l8-e/modules-Clock2Arduino/README.md

# Clock2Arduino
Documentation and Code of an Eurorack Module, which realizes a Clock Input into an [Arduino Nano](https://store.arduino.cc/products/arduino-nano)

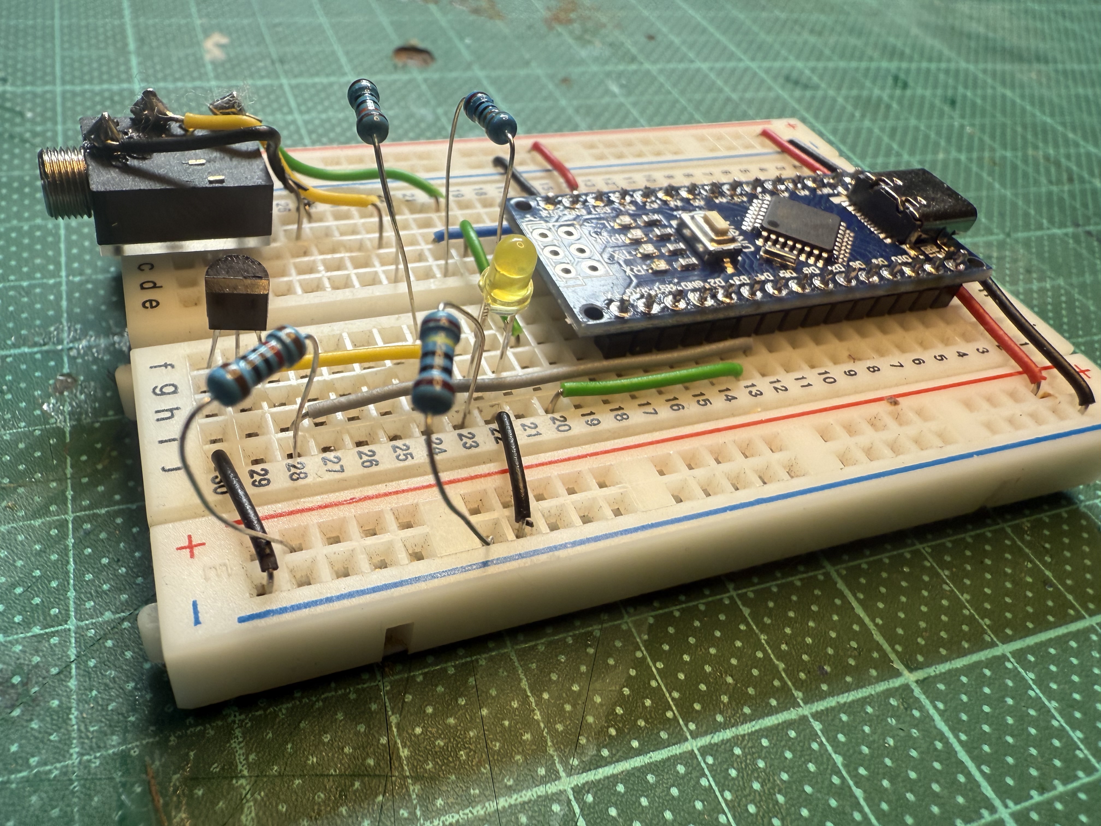
[picture p1: images/Perspective.jpg]
the current working state of the breadboard implementation


# About
I am working to build an Arduino Nano based Sequencer as Eurorack Module. 

For this I wanted to have an optional Clock Input, i.e. an jack, where one can plug  in a click signal, but does not have to. If nothing is plugged in, the Arduino shall use an internal clock instead. 
This repository here contains the schematics to build this and the code for the arduino to manage an internal clock, read an external clock and work with the corresponding signal. 

## Input Guard
An Arduino nano has some digital inputs, which expect to be either ~0V or at ~5V. Eurorack Modules create signals, which are often at ~5V, but they can be higher (or lower) in voltage, so 
it is quite risky to directly wire the input signal to the Arduino. Instead, some guarding or shielding is required to protect the arduino from being fried. 

Googling how to do this led me to this [reddit thread](https://www.reddit.com/r/synthdiy/comments/hpzyuz/what_do_i_need_to_make_an_arduino_input_pin/). From there I found the documentation of the [big honking button](https://blog.thea.codes/designing-big-honking-button/), some Eurorack Module, which has a shielded gate input. And from there I stumbled into the schematics of the [grids-module](https://pichenettes.github.io/mutable-instruments-documentation/modules/grids/downloads/grids_v02.pdf) of mutable instruments / Emilie Gillet. 

All three used an NPN-Transistor where the input-signal is connected to the base. The emitter is connected to the ground and the transistor's collector is directly connected to the arduino's input signal and via a resistor connected the 5v output of the arduino. This means, the arduino input is HIGH, when no input signal is present and as soon as the input signal receives a signal, the transistor opens up and pulls the input signal down to LOW. 
As transistor I followed the big honking button schematics and decided to go with an `2N3904`. The resistor sizes I copied from the grids design. Finally, I choose to use the `d02` port of the Arduino as input. 
This looks as follows: 

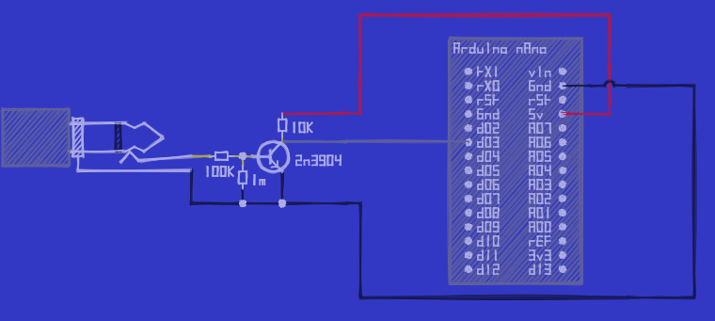
[picture p2: images/BasicGuard.png]
basic schematic of the input guard


## Make external clock Signal optional
Next, I wanted the make the clock signal optional. So I programmed an internal clock signal, which the Arduino puts out to its `d03` port. So I used a 3.5mm jack with a switch instead of an unswitched one and directly connected the `d03` port to the switch. This can be seen as the light green connection in the next image:

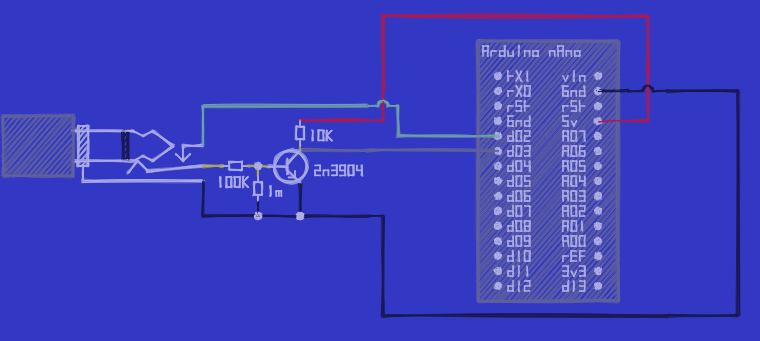
[picture p3: images/GuardWithInternalClockSignal.png]
basic schematic of the input guard


Here, it does not change anything, because a plug is inserted, which disconnects the yellow input signal from the green internal clock signal. But if no plug is present as seen in the third image, both get connected and the Arduino feeds its internal clock signal via the guard to the `d02` port and reads it there again:

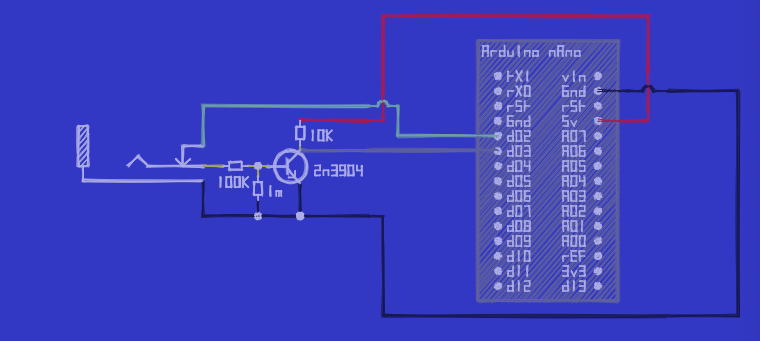
[picture p4: images/GuardWithInternalClockSignalUnplugged.png]
basic schematic of the input guard


## Add an clock LED
Last but not least I did add a LED to the port `d13` of the Arduino, such that the Arduino can show its read clock state. This mainly is for debugging and being able to see, what is going on there. This is the final schematic:

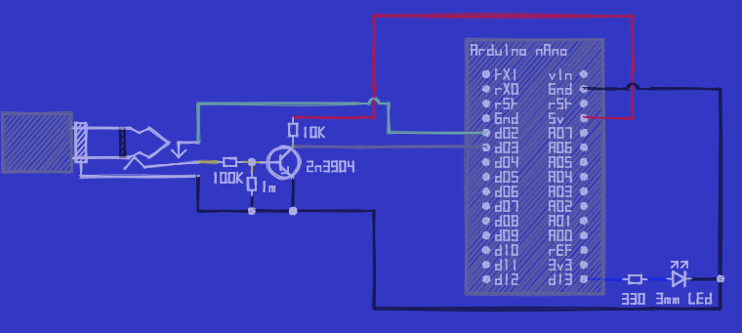
[picture p5: images/GuardWithClockLed.png]
basic schematic of the input guard


## Programming the Arduino Nano

The code for the arduino is pretty straight forward. It does not use external libraries and thus has no external dependencies. 
It creates an internal clock signal with a configurable speed and signal uptime. 
It reads an external clock signal and syncs the clock led either to the internal clock signal (for debugging) or to the external one (which might fall back to the internal one, if no plug is present in the input jack).
The code can be found in [Clock2Arduino.ino](./Clock2Arduino/Clock2Arduino.ino).

## Breadboarding

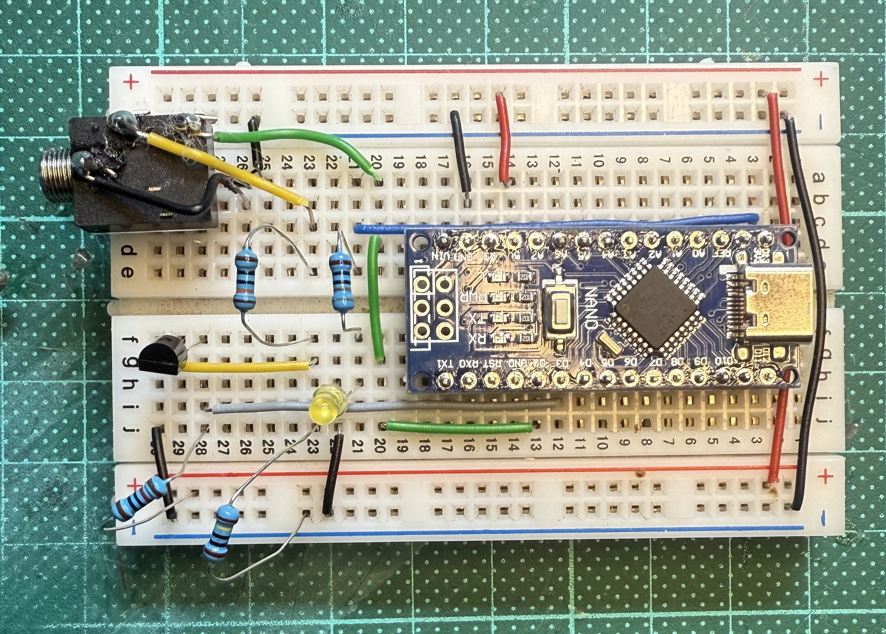
[picture p6: images/BreadBoard.jpg]
top view of the breakboard


## Using Arduino's input pullup resistor
[asciisynth](https://www.instagram.com/asciisynth/) (https://blinkenl.info) told me on instagram about the pullup resistor of the arduino. Basically, you 
can easily connect the input pin of the Arduino *in* the Arduino to +5V with a 10k resistor inbetween. In my schematic I did this by hand, 
but by changing the line `pinMode(CLOCK_IN,  INPUT);` to `pinMode(CLOCK_IN,  INPUT_PULLUP);` one can remove the resistor from the schematic and simplify it. 
This looks as follows: 

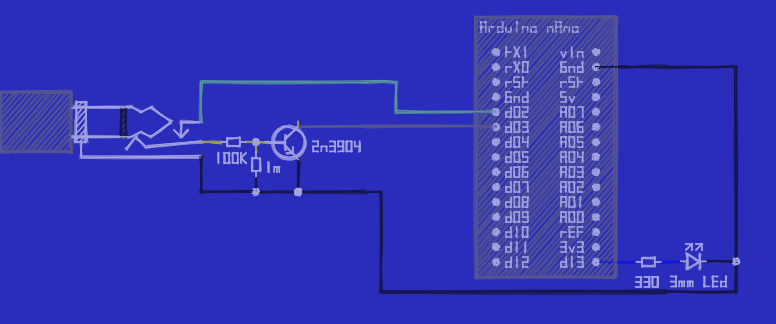
[picture p7: images/UsingInputPullup.png]
improved schematic of the input guard


The code at [Clock2Arduino.ino](./Clock2Arduino/Clock2Arduino.ino) contains now an additionel `#define` which defines, if the internal or an external pullup resistor 
shall be used. 

## Using hardware interrupts to simplify the loop
Again, [asciisynth](https://www.instagram.com/asciisynth/) (https://blinkenl.info) suggested to use hardware interrupts in the software to have a more precise timing and be able to do more "other stuff" in the loop. I tried and it works nicely. This change does not require changes to the schematic or bread board setup. The corresponding improved code can be found [here](./Clock2Arduino_interruptVersion/Clock2Arduino_interruptVersion.ino)

# Licensing
The code and documentation here is available under the [MIT License](./LICENSE-Software), the hardware design is available under [CC BY-SA 4.0](./LICENSE-Hardware).

# References
* Stargirl Flowers documentation of the big honking button with a gate guard: https://blog.thea.codes/designing-big-honking-button/
* Github repository of the big honking button: https://github.com/wntrblm/Big_Honking_Button
* Gate guard layout from Emilie Gillet for the grids module: https://pichenettes.github.io/mutable-instruments-documentation/modules/grids/downloads/grids_v02.pdf
* Arduino Nano: https://store.arduino.cc/products/arduino-nano
* [asciisynth](https://www.instagram.com/asciisynth/) (https://blinkenl.info) gave very helpful feedback to improve this
