l8-e/modules-Clock2Arduino/(commit log)

2025-06-10 Update README.md
    adding asciisynth's improvements (usage of pullup resistor and using hardware interrupts)
2025-06-10 Delete Clock2Arduino.ino
    moved the file to a subfolder, to make it work with arduino ide.
